connorwk/SQD-M.2_Root/README.md

# SQD-M.2_Root
Breakout from M.2 to a PCIe root port designed for the SQRL Acorn FPGA boards.
