connorwk/SQD-M.2_Root/SQRL-Carrier.ods

Id | Designator | Package | Quantity | Designation | Supplier and ref
1 | J1 | Conn_TE-M.2-0.5-67P-M-key-doublesided | 1 | M.2_M-key
2 | J2 | PCIE-164-02-F-D-RA | 1 | PCIE-164-02-F-D-RA
3 | C1,C20,C11,C16 | C_1206_3216Metric | 4 | 10μF
4 | C2,C4,C6,C7,C10,C12,C15,C17,C21 | C_0402_1005Metric | 9 | 100nF
5 | C3,C8 | CP_Radial_D6.3mm_P2.50mm | 2 | 47μF
6 | C13,C14,C18,C19 | C_0805_2012Metric | 4 | 22μF
7 | D1 | LED_PLCC-2 | 1 | ~ALERT~ LED
8 | D2 | LED_PLCC-2 | 1 | LED_1
9 | JP1 | PinHeader_1x02_P2.54mm_Vertical | 1 | M.2 3.3V Enable
10 | JP2 | PinHeader_1x03_P2.54mm_Vertical | 1 | ~WAKE~ Select
11 | JP3 | PinHeader_1x02_P2.54mm_Vertical | 1 | ~ALERT~ LED
12 | L1,L2 | L_Taiyo-Yuden_NR-50xx | 2 | 3.3μH
13 | R1,R2,R10,R11,R12,R13 | R_0402_1005Metric | 6 | 50Ω
14 | R3,R4,R5,R7,R8,R9 | R_0402_1005Metric | 6 | 33Ω
15 | R6 | R_0402_1005Metric | 1 | 100Ω
16 | R14,R16 | R_0402_1005Metric | 2 | 45.3kΩ
17 | R15,R17,R20 | R_0402_1005Metric | 3 | 10k
18 | R18,R19,R21,R22 | R_0402_1005Metric | 4 | 150Ω
19 | U1 | CDFN-6pin-5x3.2mm | 1 | DSC1104
20 | U2 | VQFN-16-1EP_3x3mm_P0.5mm_EP1.68x1.68mm_ThermalVias | 1 | SI53322
21 | U3,U4 | SOT-563 | 2 | TPS563231
22 | J3 | AMP-4POS-(MOLEX) | 1 | 4-Pin Molex
23 | D3 | LED_PLCC-2 | 1 | +3V3_M.2
24 | D4 | LED_PLCC-2 | 1 | +3V3_PCIe
25 | C5 | C_0402_1005Metric | 1 | 1μF
