connorwk/SQD-M.2_Root/Schematic.pdf

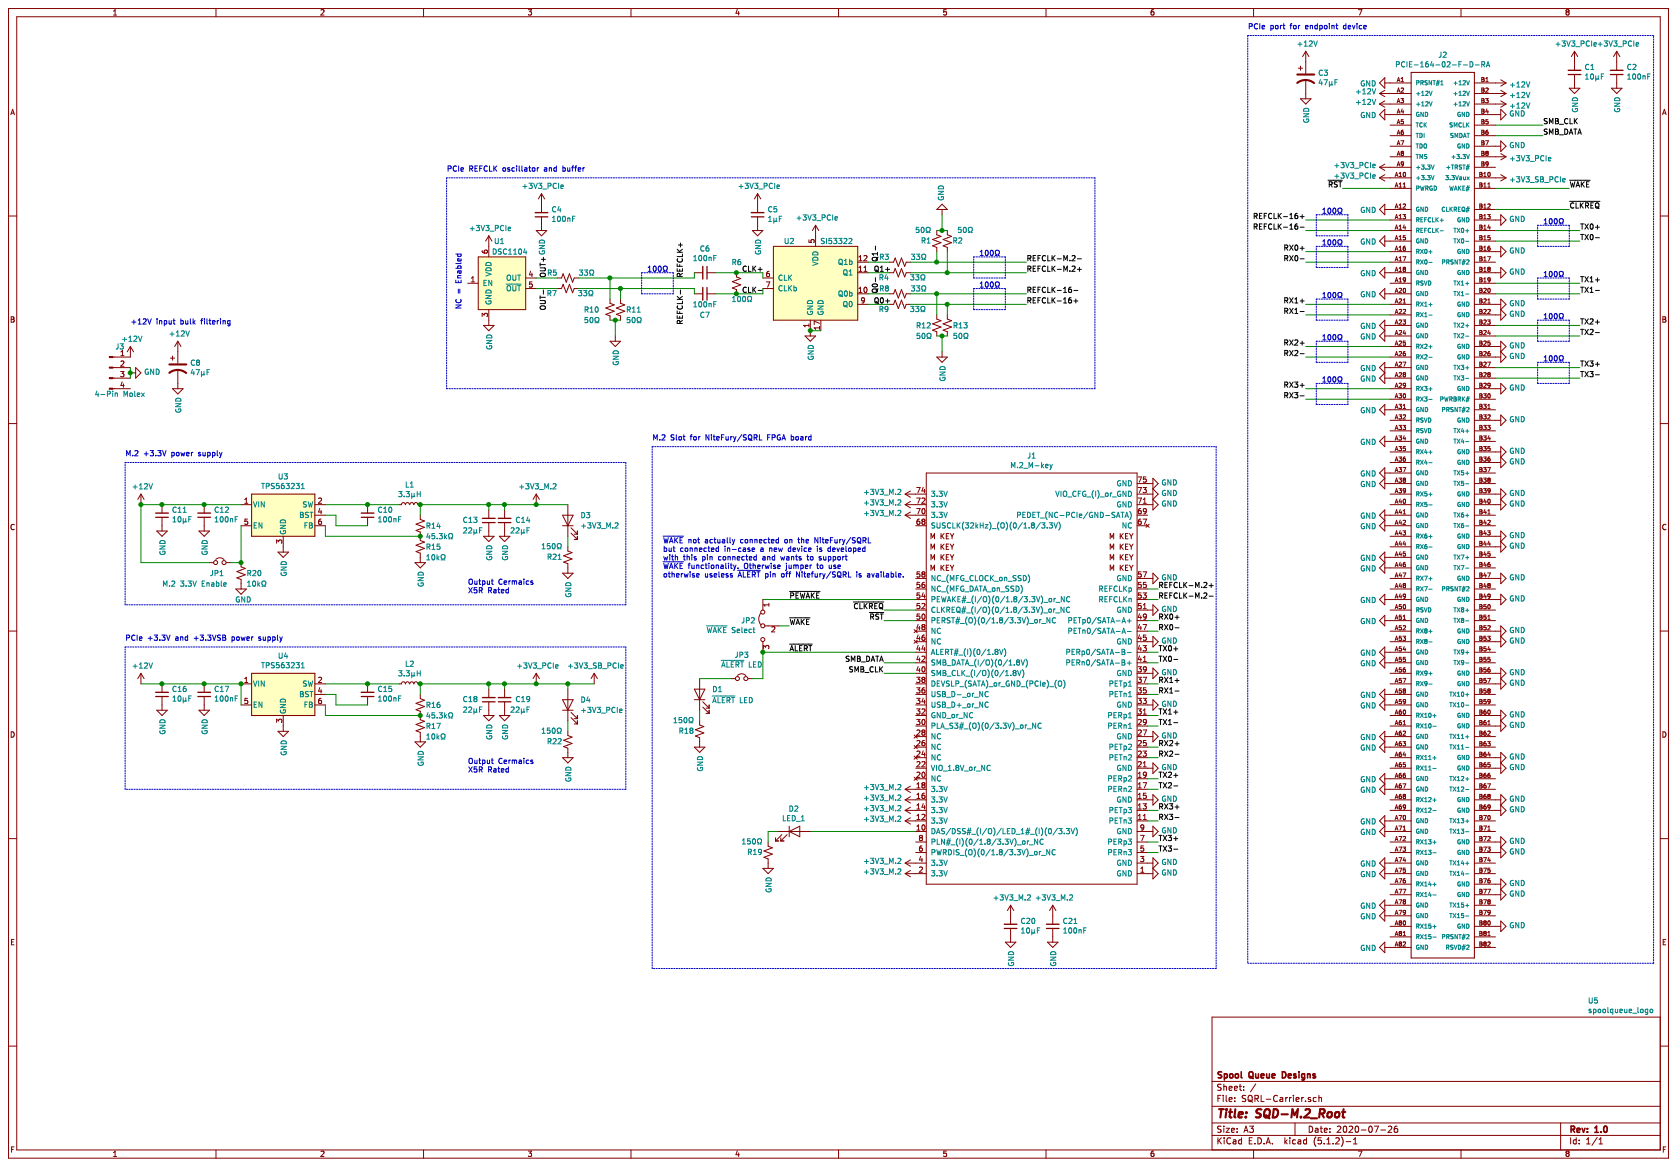
[picture p1: page 1]
