connorwk/SQD-M.2_Root/SQRL-Carrier.kicad_pcb

## KiCad design SQRL-Carrier.kicad_pcb (2020-09-16)

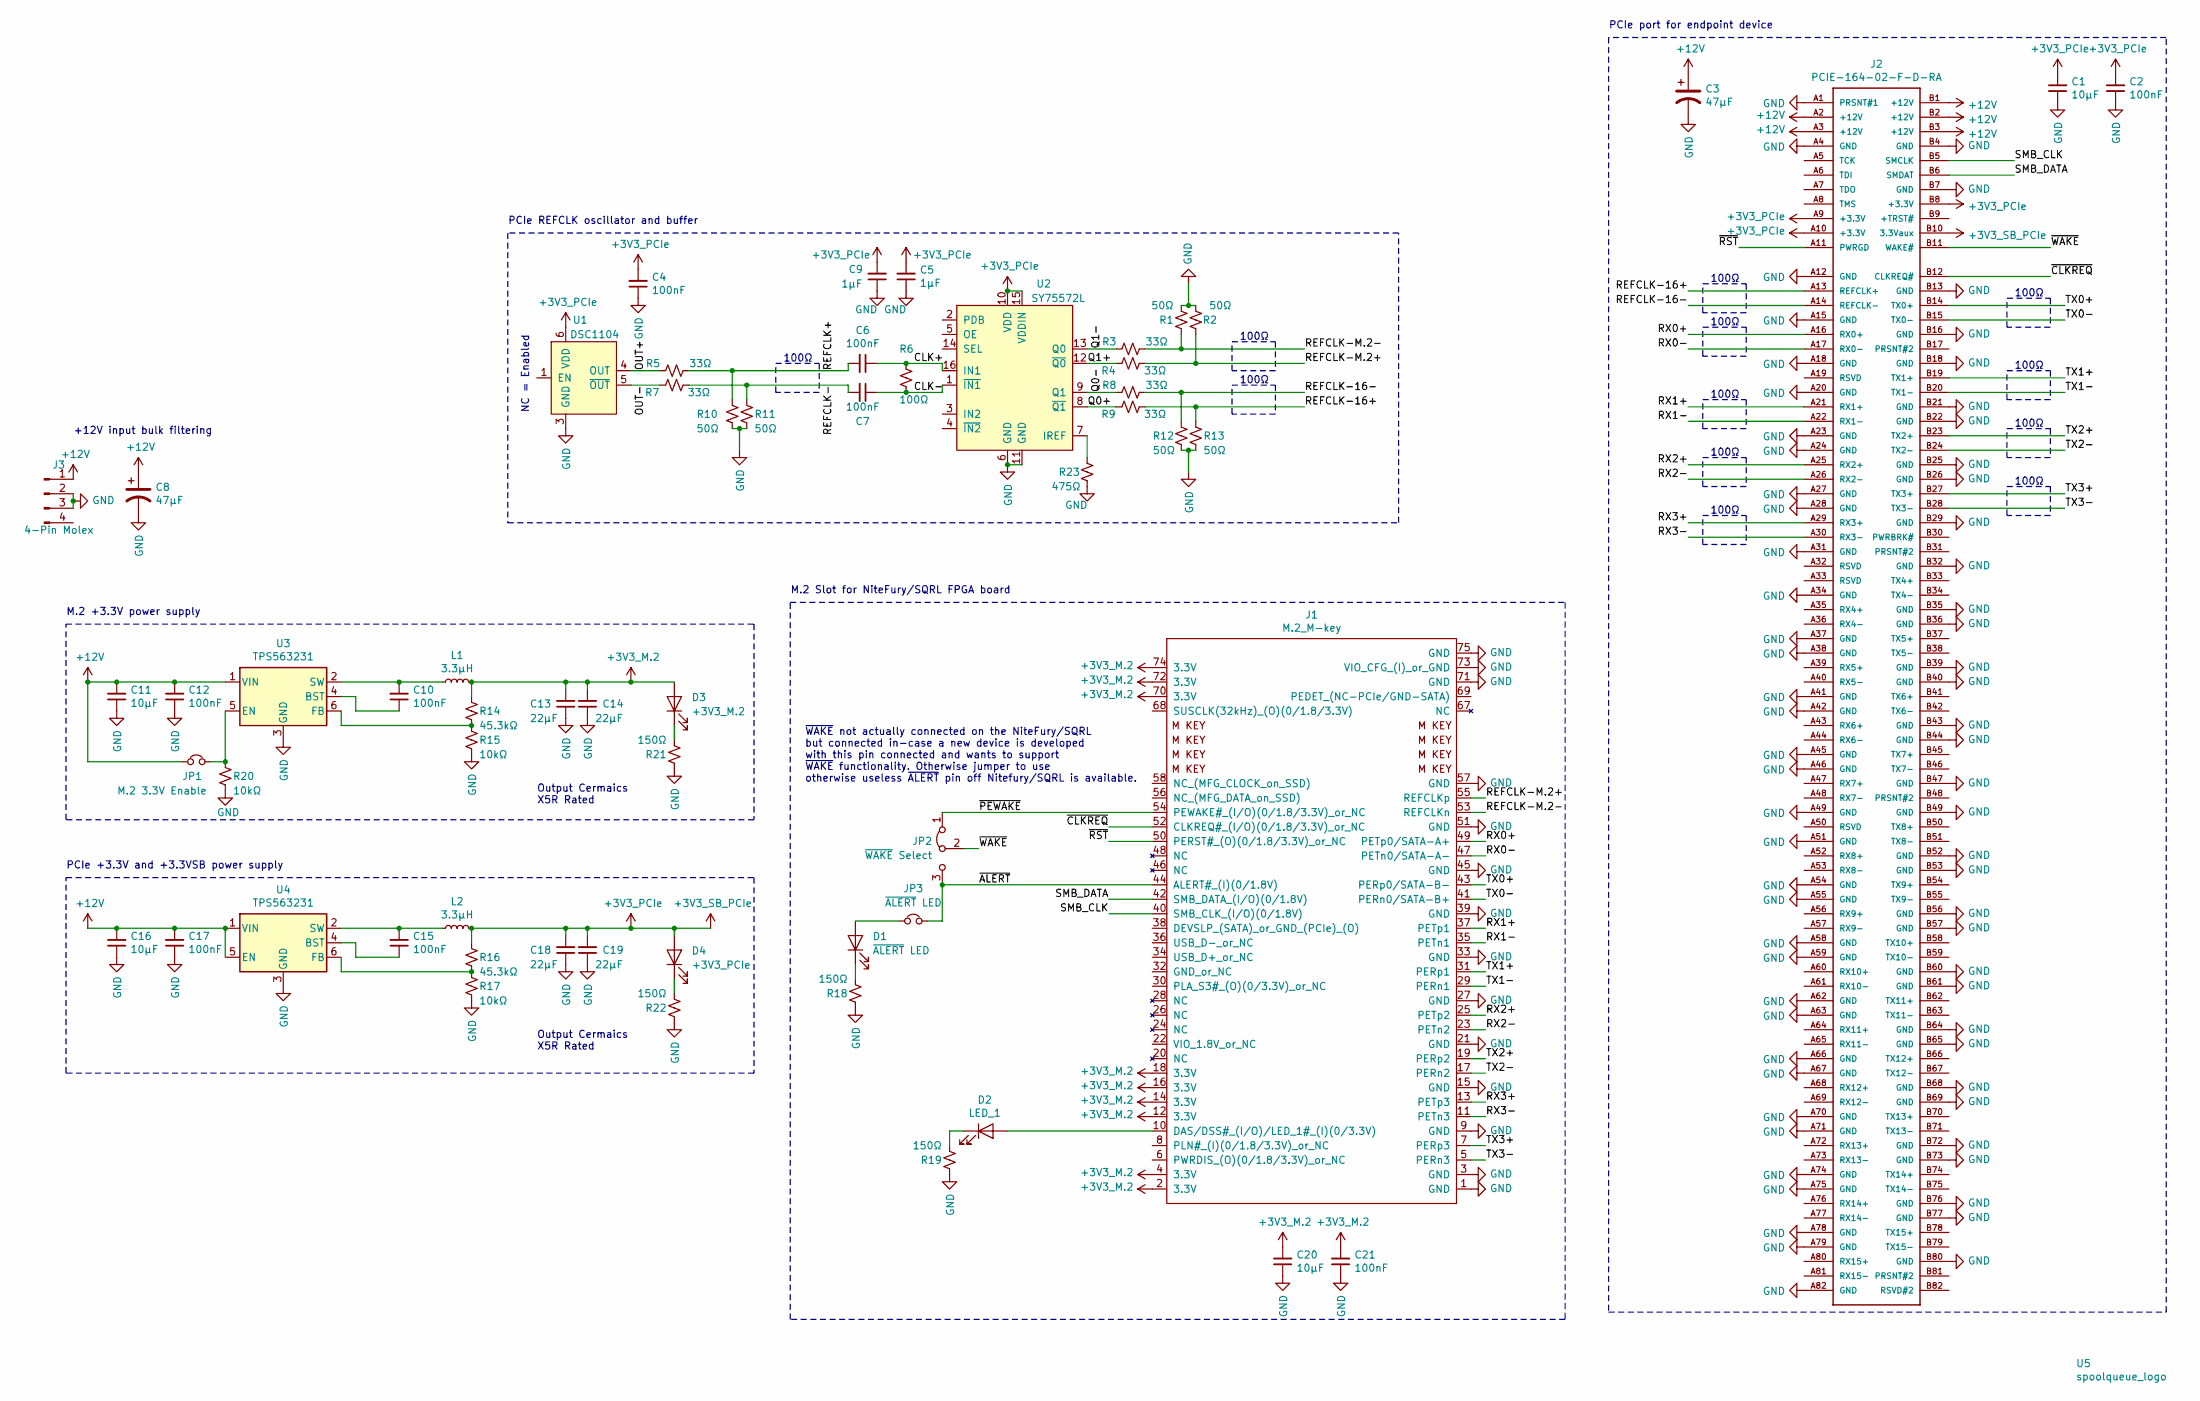
[picture p2: schematic SQRL-Carrier.sch, SQD-M.2_Root]

Parts:
C1, C11, C16, C20: 10μF; C_1206_3216Metric
C2, C4, C6, C7, C10, C12, C15, C17, C21: 100nF; C_0402_1005Metric
C3, C8: 47μF; CP_Radial_D6.3mm_P2.50mm
C5, C9: 1μF; C_0402_1005Metric
C13, C14, C18, C19: 22μF; C_0805_2012Metric
D1: ~ALERT~ LED; LED_PLCC-2
D2: LED_1; LED_PLCC-2
D3: +3V3_M.2; LED_PLCC-2
D4: +3V3_PCIe; LED_PLCC-2
J1: M.2_M-key; Conn_TE-M.2-0.5-67P-M-key-doublesided
J2: PCIE-164-02-F-D-RA
J3: 4-Pin Molex; AMP-4POS-(MOLEX)-RA
JP1: M.2 3.3V Enable; PinHeader_1x02_P2.54mm_Vertical
JP2: ~WAKE~ Select; PinHeader_1x03_P2.54mm_Vertical
JP3: ~ALERT~ LED; PinHeader_1x02_P2.54mm_Vertical
L1, L2: 3.3μH; L_Taiyo-Yuden_NR-50xx
R1, R2, R10, R11, R12, R13: 50Ω; R_0402_1005Metric
R3, R4, R5, R7, R8, R9: 33Ω; R_0402_1005Metric
R6: 100Ω; R_0402_1005Metric
R14, R16: 45.3kΩ; R_0402_1005Metric
R15, R17, R20: 10kΩ; R_0402_1005Metric
R18, R19, R21, R22: 150Ω; R_0402_1005Metric
R23: 475Ω; R_0402_1005Metric
U1: DSC1104; CDFN-6pin-5x3.2mm
U2: SY75572L; VQFN-16-1EP_3x3mm_P0.5mm_EP1.45x1.45mm
U3, U4: TPS563231; SOT-563
U5: spoolqueue_logo; spoolqueue_logo_small

Connections:
+3V3_M.2: C13.2, C14.2, C20.2, C21.2, D3.2 (A), J1.2 (3.3V), J1.4 (3.3V), J1.12 (3.3V), J1.14 (3.3V), J1.16 (3.3V), J1.18 (3.3V), J1.70 (3.3V), J1.72 (3.3V), J1.74 (3.3V), L1.2, R14.1
+3V3_PCIe: C1.2, C2.2, C4.2, C5.2, C9.2, C18.2, C19.2, D4.2 (A), J2.A9 (+3.3V), J2.A10 (+3.3V), J2.B8 (+3.3V), J2.B10 (3.3Vaux), L2.2, R16.1, U1.6 (VDD), U2.10 (VDD), U2.15 (VDDIN)
+12V: C3.1, C8.1, C11.2, C12.2, C16.2, C17.2, J2.A2 (+12V), J2.A3 (+12V), J2.B1 (+12V), J2.B2 (+12V), J2.B3 (+12V), J3.1, JP1.1, U3.1 (VIN), U4.1 (VIN), U4.5 (EN)
/CLK+: C6.1, R6.1, U2.16 (IN1)
/CLK-: C7.1, R6.2, U2.1 (~IN1~)
/OUT+: R5.2, U1.4 (OUT)
/OUT-: R7.1, U1.5 (~OUT~)
/Q0+: R9.1, U2.8 (~Q1~)
/Q0-: R8.2, U2.9 (Q1)
/Q1+: R4.1, U2.12 (~Q0~)
/Q1-: R3.2, U2.13 (Q0)
/REFCLK+: C6.2, R5.1, R10.1
/REFCLK-: C7.2, R7.2, R11.1
/REFCLK-16+: J2.A13 (REFCLK+), R9.2, R13.1
/REFCLK-16-: J2.A14 (REFCLK-), R8.1, R12.1
/REFCLK-M.2+: J1.55 (REFCLKp), R2.1, R4.2
/REFCLK-M.2-: J1.53 (REFCLKn), R1.1, R3.1
/RX0+: J1.49 (PETp0/SATA-A+), J2.A16 (RX0+)
/RX0-: J1.47 (PETn0/SATA-A-), J2.A17 (RX0-)
/RX1+: J1.37 (PETp1), J2.A21 (RX1+)
/RX1-: J1.35 (PETn1), J2.A22 (RX1-)
/RX2+: J1.25 (PETp2), J2.A25 (RX2+)
/RX2-: J1.23 (PETn2), J2.A26 (RX2-)
/RX3+: J1.13 (PETp3), J2.A29 (RX3+)
/RX3-: J1.11 (PETn3), J2.A30 (RX3-)
/SMB_CLK: J1.40 (SMB_CLK_(I/O)(0/1.8V)), J2.B5 (SMCLK)
/SMB_DATA: J1.42 (SMB_DATA_(I/O)(0/1.8V)), J2.B6 (SMDAT)
/TX0+: J1.43 (PERp0/SATA-B-), J2.B14 (TX0+)
/TX0-: J1.41 (PERn0/SATA-B+), J2.B15 (TX0-)
/TX1+: J1.31 (PERp1), J2.B19 (TX1+)
/TX1-: J1.29 (PERn1), J2.B20 (TX1-)
/TX2+: J1.19 (PERp2), J2.B23 (TX2+)
/TX2-: J1.17 (PERn2), J2.B24 (TX2-)
/TX3+: J1.7 (PERp3), J2.B27 (TX3+)
/TX3-: J1.5 (PERn3), J2.B28 (TX3-)
/~ALERT~: J1.44 (ALERT#_(I)(0/1.8V)), JP2.3 (B), JP3.2
/~CLKREQ~: J1.52 (CLKREQ#_(I/O)(0/1.8/3.3V)_or_NC), J2.B12 (CLKREQ#)
/~PEWAKE~: J1.54 (PEWAKE#_(I/O)(0/1.8/3.3V)_or_NC), JP2.1 (A)
/~RST~: J1.50 (PERST#_(O)(0/1.8/3.3V)_or_NC), J2.A11 (PWRGD)
/~WAKE~: J2.B11 (WAKE#), JP2.2 (C)
GND: C1.1, C2.1, C3.2, C4.1, C5.1, C8.2, C9.1, C11.1, C12.1, C13.1, C14.1, C16.1, C17.1, C18.1, C19.1, C20.1, C21.1, J1.1 (GND), J1.3 (GND), J1.9 (GND), J1.15 (GND), J1.21 (GND), J1.27 (GND), J1.33 (GND), J1.39 (GND), J1.45 (GND), J1.51 (GND), J1.57 (GND), J1.71 (GND), J1.73 (VIO_CFG_(I)_or_GND), J1.75 (GND), J2.A1 (PRSNT#1), J2.A4 (GND), J2.A12 (GND), J2.A15 (GND), J2.A18 (GND), J2.A20 (GND), J2.A23 (GND), J2.A24 (GND), J2.A27 (GND), J2.A28 (GND), J2.A31 (GND), J2.A34 (GND), J2.A37 (GND), J2.A38 (GND), J2.A41 (GND), J2.A42 (GND), J2.A45 (GND), J2.A46 (GND), J2.A49 (GND), J2.A51 (GND), J2.A54 (GND), J2.A55 (GND), J2.A58 (GND), J2.A59 (GND), J2.A62 (GND), J2.A63 (GND), J2.A66 (GND), J2.A67 (GND), J2.A70 (GND), J2.A71 (GND), J2.A74 (GND), J2.A75 (GND), J2.A78 (GND), J2.A79 (GND), J2.A82 (GND), J2.B4 (GND), J2.B7 (GND), J2.B13 (GND), J2.B16 (GND), J2.B18 (GND), J2.B21 (GND), J2.B22 (GND), J2.B25 (GND), J2.B26 (GND), J2.B29 (GND), J2.B32 (GND), J2.B35 (GND), J2.B36 (GND), J2.B39 (GND), J2.B40 (GND), J2.B43 (GND), J2.B44 (GND), J2.B47 (GND), J2.B49 (GND), J2.B52 (GND), J2.B53 (GND), J2.B56 (GND), J2.B57 (GND), J2.B60 (GND), J2.B61 (GND), J2.B64 (GND), J2.B65 (GND), J2.B68 (GND), J2.B69 (GND), J2.B72 (GND), J2.B73 (GND), J2.B76 (GND), J2.B77 (GND), J2.B80 (GND), J3.2, J3.3, R1.2, R2.2, R10.2, R11.2, R12.2, R13.2, R15.2, R17.2, R18.1, R19.1, R20.2, R21.1, R22.1, R23.2, U1.3 (GND), U2.6 (GND), U2.11 (GND), U3.3 (GND), U4.3 (GND)
unnamed: C10.1, U3.4 (BST)
unnamed: C10.2, L1.1, U3.2 (SW)
unnamed: C15.1, U4.4 (BST)
unnamed: C15.2, L2.1, U4.2 (SW)
unnamed: D1.1 (K), R18.2
unnamed: D1.2 (A), JP3.1
unnamed: D2.1 (K), R19.2
unnamed: D2.2 (A), J1.10 (DAS/DSS#_(I/O)/LED_1#_(I)(0/3.3V))
unnamed: D3.1 (K), R21.2
unnamed: D4.1 (K), R22.2
unnamed: JP1.2, R20.1, U3.5 (EN)
unnamed: R14.2, R15.1, U3.6 (FB)
unnamed: R16.2, R17.1, U4.6 (FB)
unnamed: R23.1, U2.7 (IREF)

Notes on the sheet:
100Ω
~WAKE~ not actually connected on the NiteFury/SQRL but connected in-case a new device is developed with this pin connected and wants to support ~WAKE~ functionality. Otherwise jumper to use otherwise useless ~ALERT~ pin off Nitefury/SQRL is available.
M.2 +3.3V power supply
PCIe +3.3V and +3.3VSB power supply
+12V input bulk filtering
Output Cermaics X5R Rated
PCIe REFCLK oscillator and buffer
M.2 Slot for NiteFury/SQRL FPGA board
PCIe port for endpoint device
NC = Enabled

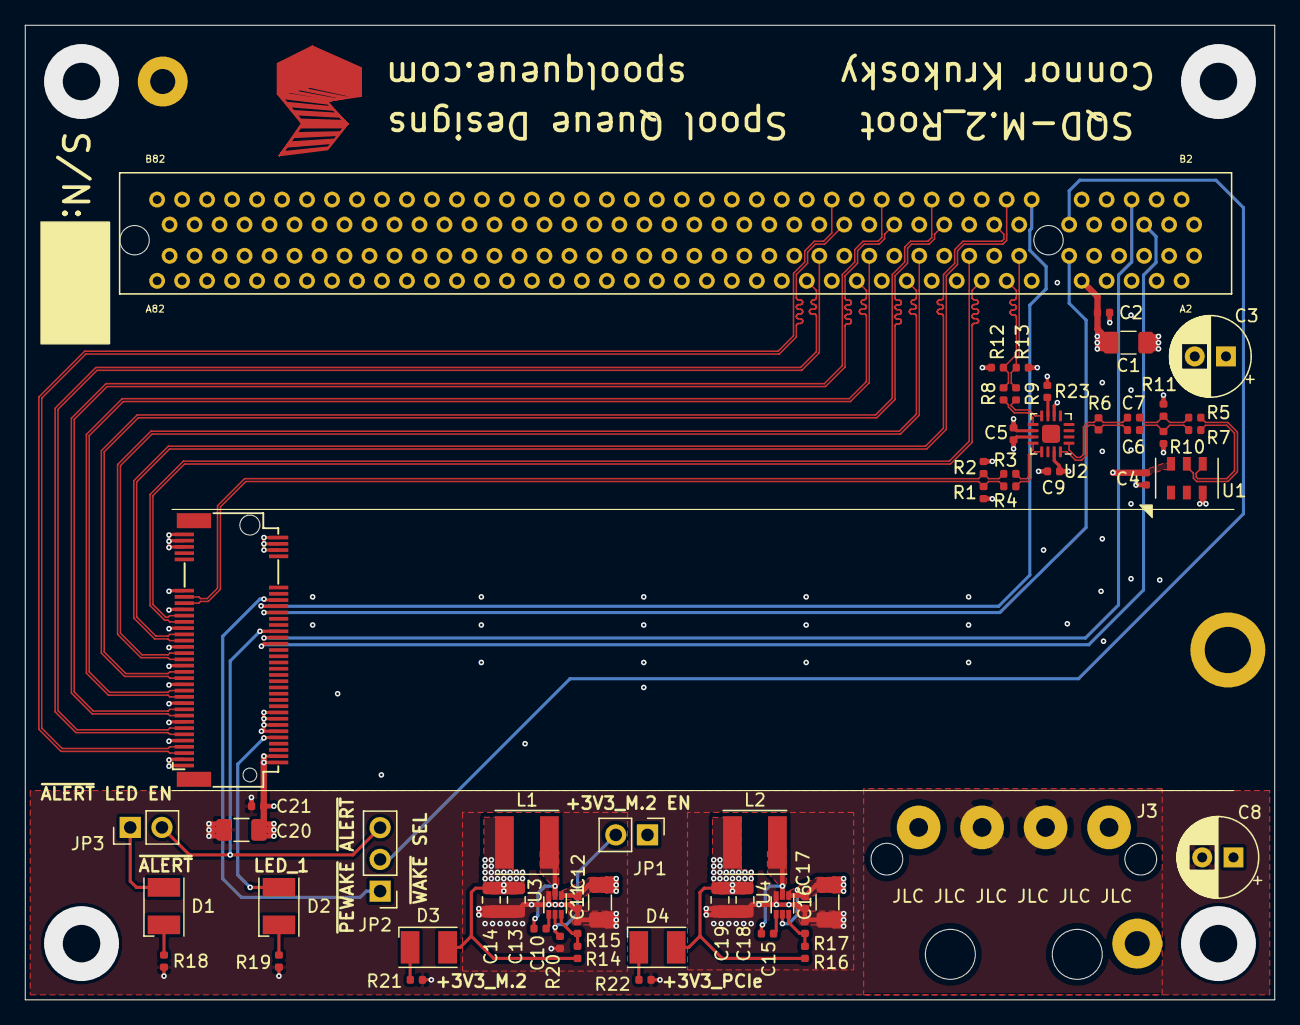
[picture p3: board SQRL-Carrier.kicad_pcb from above]

Board: 4 copper layers, 100.0 x 78.0 mm, 61 parts (0 on the bottom side), 55 nets.
