connorwk/SQD-M.2_Root/(commit log)

2020-08-26 Initial commit of hardware revision 1.0
    [SQRL-Carrier.kicad_pcb, SQRL-Carrier.ods, SQRL-Carrier.sch]
2020-09-16 Hardware revision 2
    [SQRL-Carrier.kicad_pcb, SQRL-Carrier.sch]
